Ahan-Trivedi2/eclectronics_mp1/Report/Eclectronics_MP1_Report_Ahan_Trivedi.pdf

## Eclectronics MP1

Ahan Trivedi

September 15, 2026

## 1 Circuit Design

The overall circuit takes 5V from USB, regulates it down to 3.3V, and uses the 3.3V supply to power a hysteretic oscillator. A voltage divider and unity-gain follower provide a stable 1.65V reference for the oscillator. The oscillator output then drives an LED, producing a flash period of approximately 1 second. This is done entirely with analog circuitry, without any digital logic or external clock. The complete circuit schematic is shown below.

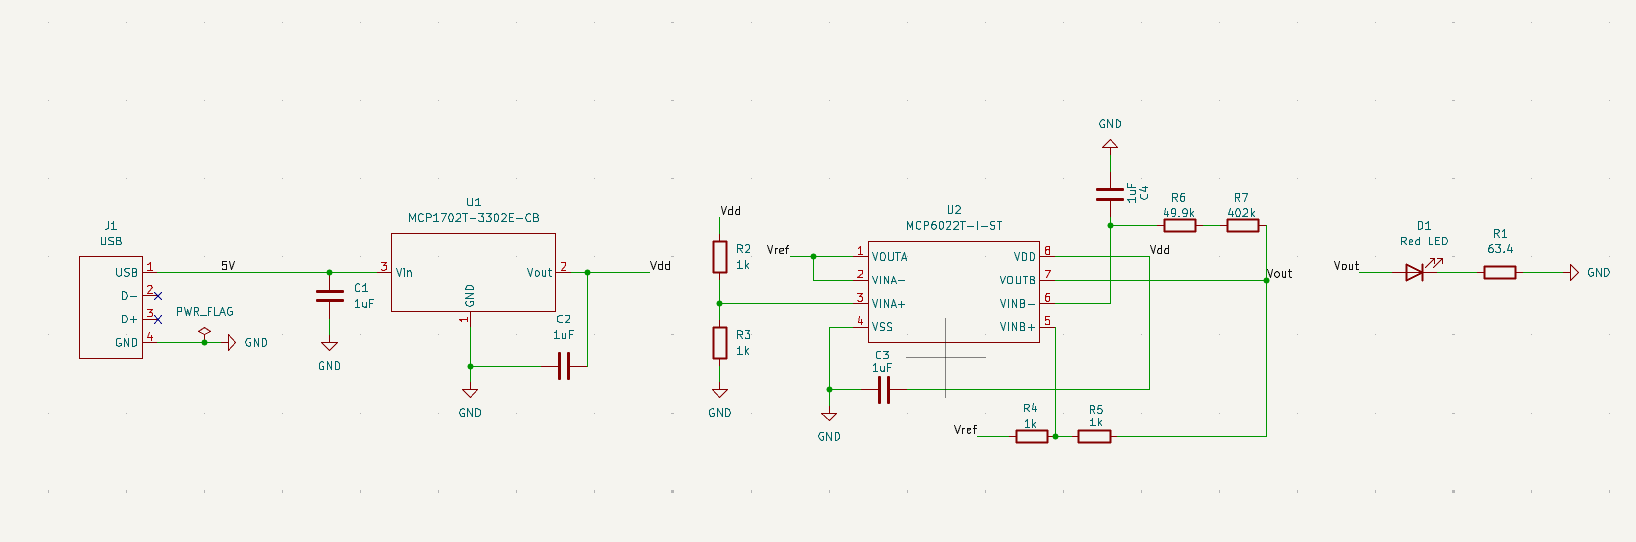
[picture p1: figure]

Figure 1: Complete circuit schematic for the USB-powered LED flasher.

## 2 Parts Selection

I first went through the provided parts list and datasheets to choose the main components needed for
the circuit. I selected the provided USB connector, the MCP1702T-3302E/CB 3.3V LDO, the MCP6022T-I/ST dual op-amp, the LTST-C171KRKT red LED, and appropriate resistors and capacitors. The dual op-amp was useful because I could use one op-amp for buffering the voltage reference and the other for the hysteretic oscillator.

## 3 USB Input and LDO

The circuit is powered from the 5V USB VBUS and GND pins, while the two USB data pins are left unconnected. VBUS is connected to the input of the MCP1702T-3302E/CB 3.3V LDO, which I wired according to its datasheet. Following the datasheet recommendations, I also included two 1 µF bypass capacitors, one at VIN and one between VDD and GND.

## 4 1.65 V Reference

Since the oscillator operates between 0 V and 3.3 V, I chose the midpoint of the supply as the reference voltage:

Vref =

3.3
2

= 1.65 V.

I generated this reference using two equal 1 kΩ resistors as a voltage divider:

Vref = 3.3

(︃
1 kΩ

1 kΩ + 1 kΩ)︃
= 1.65 V.

I then used one half of the MCP6022T-I/ST as a unity-gain voltage follower. The follower does not change the reference voltage, but buffers the voltage divider so that loading from the oscillator does not significantly change Vref.

## 5 Hysteretic Oscillator

The second half of the MCP6022T-I/ST is used to create an inverting hysteretic oscillator. The positivefeedback resistor network sets the Schmitt-trigger switching thresholds, while the timing resistor and capacitor determine how quickly the circuit moves between those thresholds.

I chose the Schmitt-trigger feedback resistances to have a 1:1 ratio, giving

α = 0.5.

With VDD = 3.3 V and Vref = 1.65 V, this produces symmetric switching thresholds of

Vup = αVref = (0.5)(1.65) = 0.825 V,

and

Vdn = VDD − α(VDD − Vref) = 3.3 − 0.5(3.3 − 1.65) = 2.475 V.

These thresholds are symmetric around 1.65 V, so the ideal charging and discharging times are equal, resulting in approximately a 50% duty cycle.

When the oscillator output is HIGH, the timing capacitor charges through the timing resistor until its voltage reaches 2.475 V. The Schmitt trigger then switches the output LOW. The capacitor then discharges until it reaches 0.825 V, at which point the output switches HIGH again. This process repeats continuously to create the oscillation.

## 6 Oscillator Period

For the discharging portion of the cycle,

Tl = RC ln (︃
Vdn

Vup )︃

Using the selected thresholds,

Tl = RC ln (︃
2.475

0.825)︃
= RC ln(3) = 1.0986RC.

Because the thresholds are symmetric, the charging time is the same:

Th = 1.0986RC.

The total period is therefore

T = Tl + Th

and

T = 2(1.0986RC) = 2.197RC.

For a target period of 1 second, the required RC time constant is

RC =

1
2.197

≈ 0.455 s.

I selected a timing capacitor of

C = 1 µF

and a timing resistance of

R = 451.9 kΩ.

This gives

RC = (451.9 kΩ)(1 µF) = 0.4519 s.

The resulting nominal period is

T = 2.197(0.4519) ≈ 0.993 s,

which is very close to the desired 1 second period.

## 7 Simulation and Component Tolerances

Since the calculated nominal period was very close to the desired 1 second period, I was satisfied with the selected RC values. I then modeled the oscillator and unity-gain follower in LTSpice to determine how component variation could affect the period. I used the specified component tolerances of ±1% for the resistors and ±10% for the 1 µF capacitor. These tolerances were modeled using Gaussian variations in LTSpice, and I ran 250 simulations with randomly varied component values.

The LTSpice setup used for this tolerance analysis is shown in Figure 2.

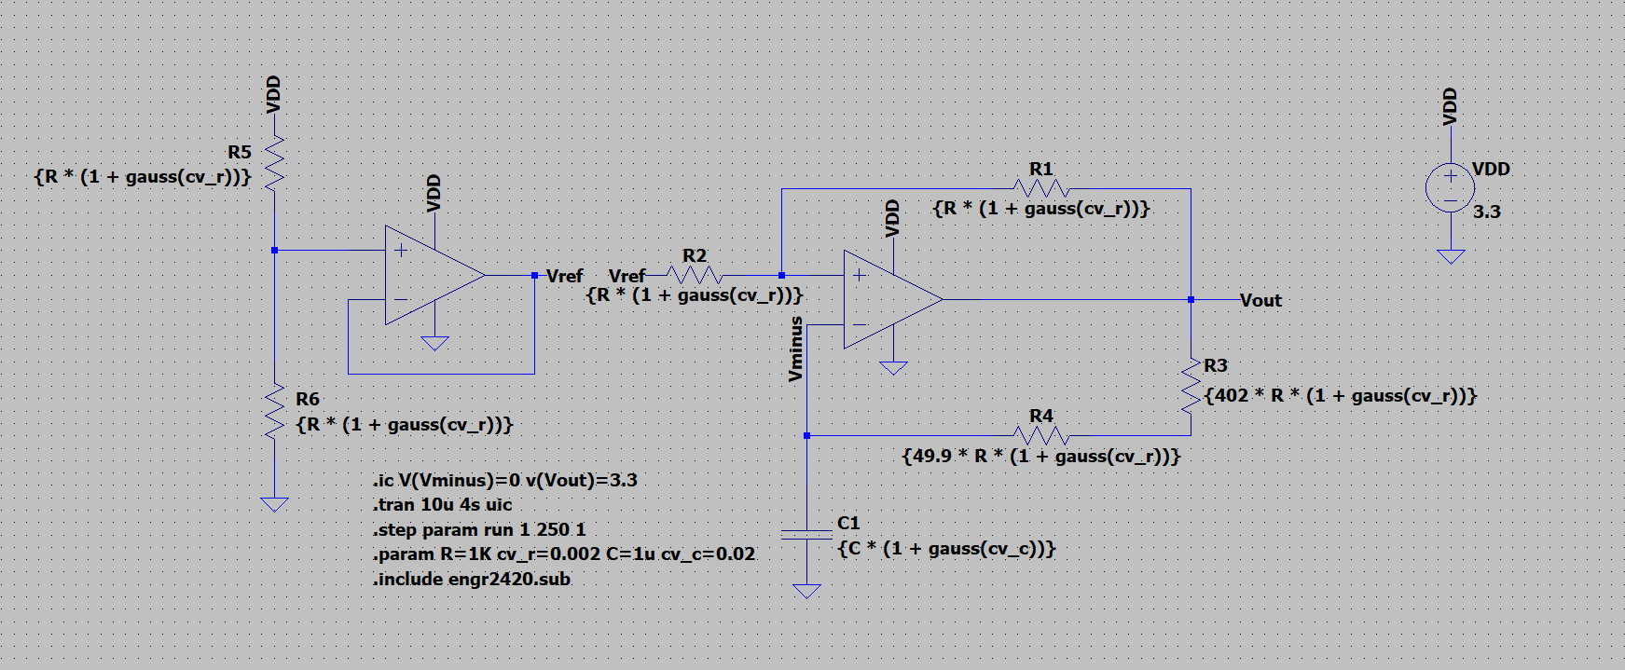
[picture p2: figure]

Figure 2: LTSpice setup used for the component tolerance simulations.

I then ran the LTSpice simulation and probed Vout, producing the oscillating output waveform shown in Figure 3.

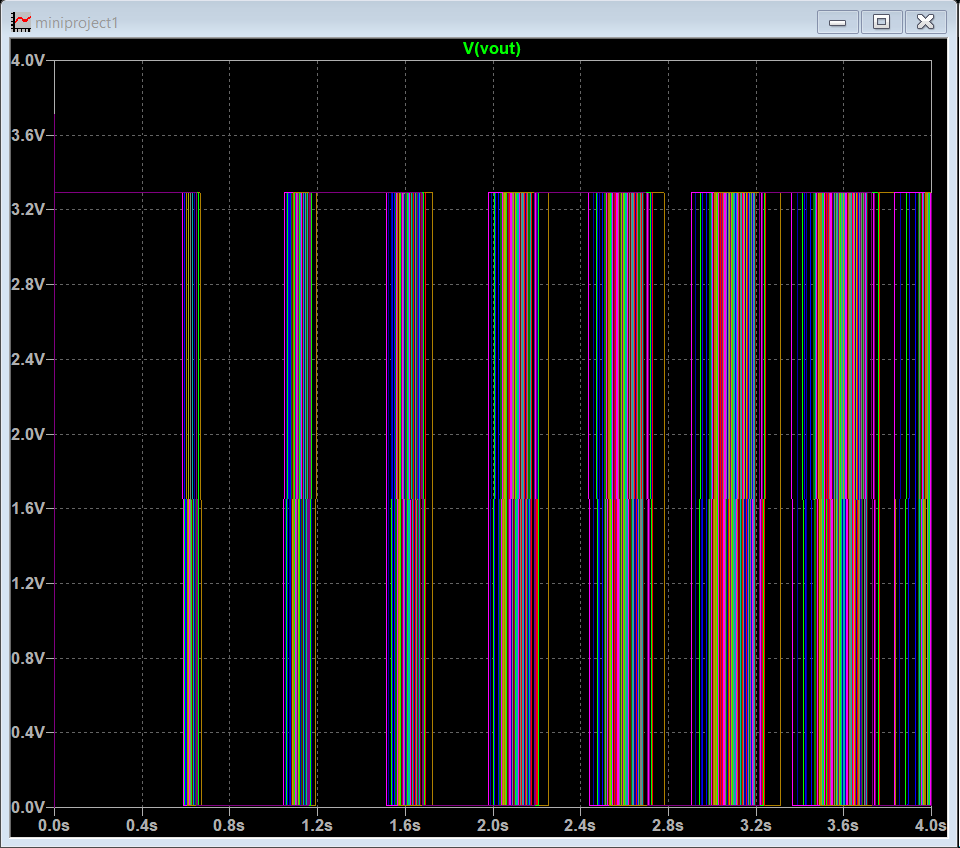
[picture p3: figure]

Figure 3: Example oscillator output waveform from LTSpice.

I then processed the output waveforms from all 250 simulations in MATLAB. For each simulation run, the script identified the rising edges of Vout and calculated the time between consecutive rising edges to determine each oscillation period. These period measurements were then averaged within each run, giving one average period for each of the 250 simulations. The distribution of these average periods is shown in Figure 4.

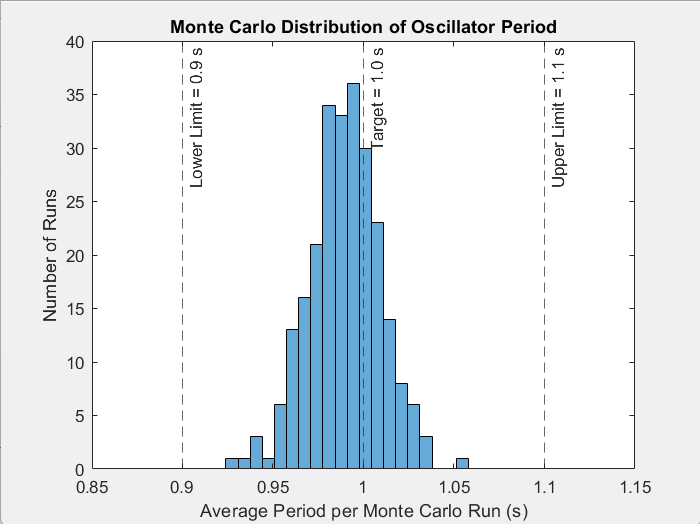
[picture p4: figure]

Figure 4: Distribution of the average oscillator period across the 250 Monte Carlo simulations.

I then compared the average period from each simulation against the required ±10% tolerance around the desired 1 second period. This corresponds to an acceptable period range of 0.9–1.1 seconds. Figure 5 shows the average period from each of the 250 simulations along with the target period and tolerance limits.

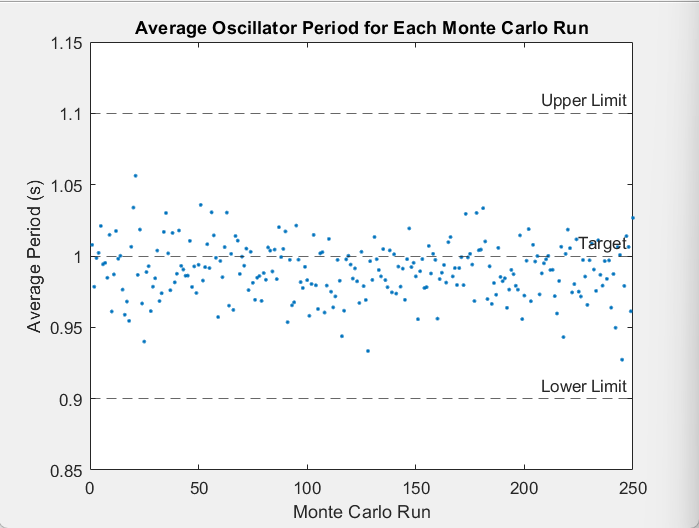
[picture p5: figure]

Figure 5: Average oscillator period for each of the 250 Monte Carlo simulations, with the 1 second target and ±10% limits shown.

All 250 simulated average periods remained within the required 0.9–1.1 second range. Because the oscillator and voltage-reference circuitry determine the timing of the LED flasher, I assumed that if this subsystem met the period requirement under component variation, the complete circuit would also meet the required period specification.

## 8 LED Output

The oscillator output drives an LTST-C171KRKT red LED through a current-limiting resistor. I targeted an LED current of approximately 20 mA. From the LED’s datasheet provided I–V curve, I estimated a forward voltage of approximately

VF ≈ 2.05 V

at 20 mA.

The voltage across the current-limiting resistor is therefore approximately

VR = 3.3 − 2.05 = 1.25 V.

The required resistance is

R =

VR

ILED

=

1.25
0.020

= 62.5 Ω.

I selected the closest available resistor value,

RLED = 63.4 Ω.

This gives an estimated LED current of

ILED =

3.3 − 2.05
63.4

≈ 19.7 mA.

Therefore, the 63.4 Ω current-limiting resistor keeps the estimated LED current close to the desired 20 mA when the oscillator output is HIGH.
