Ahan-Trivedi2/eclectronics_mp1/BoM/Eclectronics MP1 Bom.xlsx

Reference | Qty | Value | Part Description | Digikey Catalog # | Manufacturer Part #
J1 | 1 | USB_A | CONN PLUG USB 4POS RT ANG PCB | WM17117-ND | 480370001
U1 | 1 | MCP1702T-3302E/CB | IC REG LIN 3.3V 250MA SOT23A-3 | MCP1702T-3302E/CBCT-ND | MCP1702T-3302E/CB
U2 | 1 | MCP6022 | IC OPAMP GP 10MHZ RRO 8TSSOP | MCP6022T-I/STCT-ND | MCP6022T-I/ST
D1 | 1 | LTST-C171KRKT | LED RED CLEAR 0805 SMD | 160-1427-1-ND | LTST-C171KRKT
C1, C2, C3, C4 | 4 | 1uF | CAP CER 1UF 25V X7R 0603 | 399-7376-1-ND | C0603C105K3RACTU
R2, R3, R4, R5 | 4 | 1kΩ | RES SMD 1K OHM 1% 1/10W 0603 | 311-1.00KHRCT-ND | RC0603FR-071KL
R7 | 1 | 402kΩ | RES SMD 402K OHM 1% 1/10W 0603 | 311-402KHRCT-ND | RC0603FR-07402KL
R6 | 1 | 49.9kΩ | RES SMD 49.9K OHM 1% 1/10W 0603 | 311-49.9KHRCT-ND | RC0603FR-0749K9L
R1 | 1 | 63.4Ω | RES SMD 63.4 OHM 1% 1/10W 0603 | 311-63.4HRCT-ND | RC0603FR-0763R4L
