Ahan-Trivedi2/eclectronics_mp1/LTspice/miniproject1.asc

C1: capacitor; {C * (1 + gauss(cv_c))}
R1: resistor; {R * (1 + gauss(cv_r))}
R2: resistor; {R * (1 + gauss(cv_r))}
R3: resistor; {402 * R * (1 + gauss(cv_r))}
R4: resistor; {49.9 * R * (1 + gauss(cv_r))}
R5: resistor; {R * (1 + gauss(cv_r))}
R6: resistor; {R * (1 + gauss(cv_r))}
U1: opamprails
U2: opamprails
VDD: vsource; 3.3
Named nets: 0, VDD, Vout, Vminus, Vref
.ic V(Vminus)=0 v(Vout)=3.3
.tran 10u 4s uic
.step param run 1 250 1
.include engr2420.sub
.param R=1K cv_r=0.002 C=1u cv_c=0.02
