Ahan-Trivedi2/eclectronics_mp1/KiCad_Design_Files/mp1.kicad_pcb

## KiCad design KiCad_Design_Files/mp1.kicad_pcb (2026-09-17)

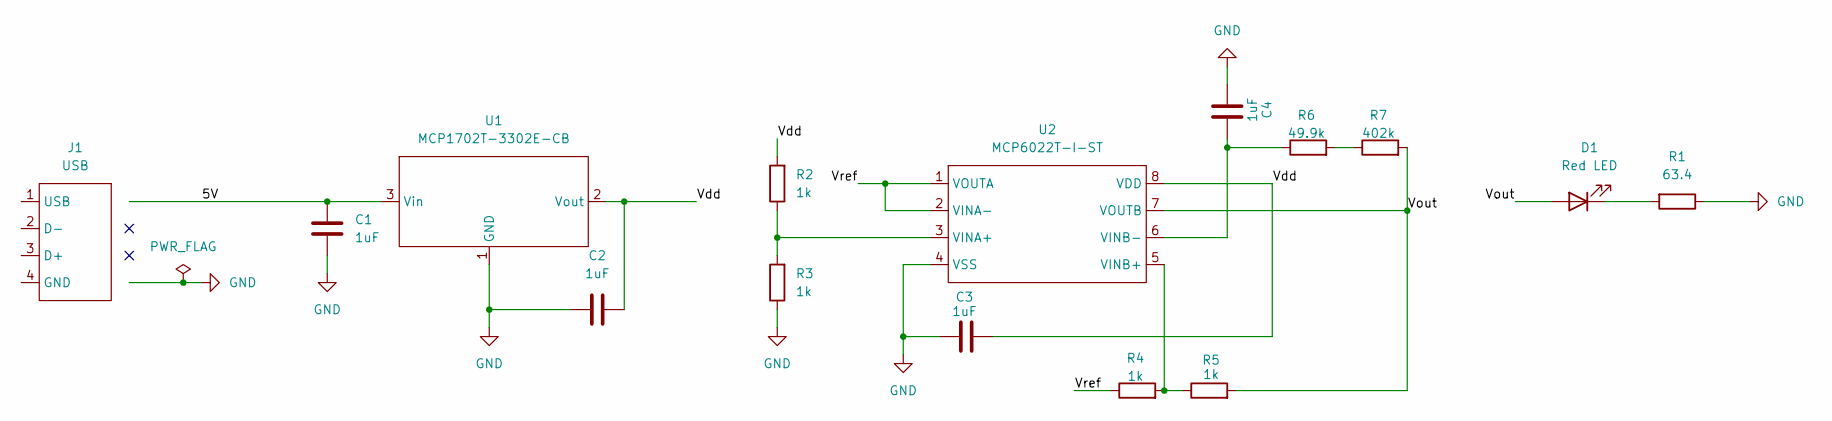
[picture p6: schematic mp1.kicad_sch]

Parts:
C1, C2, C3, C4: 1uF; C_0603_1608Metric
D1: Red LED; LED_0805_2012Metric
J1: USB; CONN_480370001_MOL
R1: 63.4; R_0603_1608Metric
R2, R3, R4, R5: 1k; R_0603_1608Metric
R6: 49.9k; R_0603_1608Metric
R7: 402k; R_0603_1608Metric
U1: MCP1702T-3302E-CB; SOT-23A_MC_MCH
U2: MCP6022T-I-ST; TSSOP8_MC_MCH

Connections:
/5V: C1.1, J1.1 (USB), U1.3 (Vin)
/Vdd: C2.1, C3.1, R2.2, U1.2 (Vout), U2.8 (VDD)
/Vout: D1.2 (A), R5.2, R7.2, U2.7 (VOUTB)
/Vref: R4.1, U2.1 (VOUTA), U2.2 (VINA-)
GND: C1.2, C2.2, C3.2, C4.2, J1.4 (GND), R1.1, R3.1, U1.1 (GND), U2.4 (VSS)
unnamed: D1.1 (K), R1.2
unnamed: R6.2, R7.1
unnamed: R2.1, R3.2, U2.3 (VINA+)
unnamed: R4.2, R5.1, U2.5 (VINB+)
unnamed: C4.1, R6.1, U2.6 (VINB-)

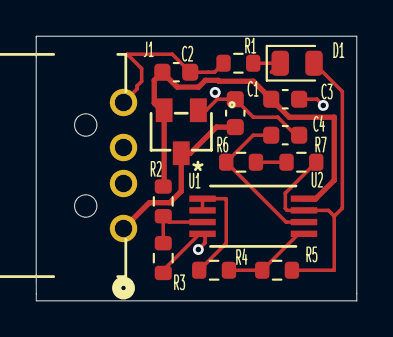
[picture p7: board mp1.kicad_pcb from above]

Board: 2 copper layers, 17.8 x 14.7 mm, 15 parts (0 on the bottom side), 10 nets.
